Eronwu/roc_robot/application/roc_car/docs/env_part.md

# 软件环境搭建篇

这部分直接参考官方给的环境搭建，非常完整，不在重复编写
STM32 运行：https://github.com/RT-Thread/rt-thread/tree/master/bsp/stm32
ENV工具：ENV工具可以通过以下链接获取：https://pan.baidu.com/s/1cg28rk#list/path=%2F
