Eronwu/roc_robot/application/roc_car/docs/mobile_wifi_code_part.md

# 手机wifi控制篇

### 简介

- 协议部分同文档[小车应用篇](app_code_part.md#协议部分) - 【协议部分】说明
- 使用标准tcp协议进行连接通信
- 通过不同按键响应拼凑不同字节流进行tcp socket 数据发送

### 开发环境

Android studio

需要的可以通过这里下载[android app](https://github.com/emakefun/hummer-bot/blob/Hummer-bot4.0/APP/Emakefun_Robot.apk)

PC端软件 还有点小bug 用QT开发
