Eronwu/roc_robot/(list of files, cad)

Other CAD files:
application/roc_car/docs/roc_robot_structure.SLDDRW
