Eronwu/roc_robot/application/roc_car/applications/wifi_connect.c

/*
 * Copyright (c) 2006-2018, RT-Thread Development Team
 *
 * SPDX-License-Identifier: Apache-2.0
 *
 * Change Logs:
 * Date           Author       Notes
 * 2018-09-01     ZeroFree     first implementation
 */

#include <rtthread.h>
#include <rtdevice.h>
#include <board.h>
#include <msh.h>

#include <board.h>
#include <rtdevice.h>

#include "drv_wlan.h"
#include "wifi_config.h"

#include <stdio.h>
#include <stdlib.h>
#include <string.h>

#define DBG_SECTION_NAME "main"
#define DBG_LEVEL DBG_LOG
#include <rtdbg.h>

#define WLAN_SSID "emakefun"
#define WLAN_PASSWORD "emakefun501"
#define NET_READY_TIME_OUT (rt_tick_from_millisecond(15 * 1000))

#define WIFI_CONNECT_LED_PIN    PIN_LED_G

static void print_scan_result(struct rt_wlan_scan_result *scan_result);
static void print_wlan_information(struct rt_wlan_info *info);

static struct rt_semaphore net_ready;

void wlan_ready_handler(int event, struct rt_wlan_buff *buff, void *parameter)
{
    rt_sem_release(&net_ready);
}

/* 断开连接回调函数 */
void wlan_station_disconnect_handler(int event, struct rt_wlan_buff *buff, void *parameter)
{
    LOG_I("disconnect from the network!");
}

int wifi_auto_connect(void)
{
    int result = RT_EOK;
    struct rt_wlan_info info;
    struct rt_wlan_scan_result *scan_result;


   // rt_pin_write(WIFI_CONNECT_LED_PIN, PIN_LOW);
    /* 等待 500 ms 以便 wifi 完成初始化 */
    rt_hw_wlan_wait_init_done(500);

    /* 扫描热点 */
    LOG_D("start to scan ap ...");
    /* 执行同步扫描 */
    scan_result = rt_wlan_scan_sync();
    if (scan_result)
    {
        LOG_D("the scan is complete, results is as follows: ");
        /* 打印扫描结果 */
        print_scan_result(scan_result);
        /* 清除扫描结果 */
        rt_wlan_scan_result_clean();
    } else {
        LOG_E("not found ap information ");
        return -1;
    }

    /* 热点连接 */
    LOG_D("start to connect ap ...");
    rt_sem_init(&net_ready, "net_ready", 0, RT_IPC_FLAG_FIFO);

    /* 注册 wlan ready 回调函数 */
    rt_wlan_register_event_handler(RT_WLAN_EVT_READY, wlan_ready_handler, RT_NULL);
    /* 注册 wlan 断开回调函数 */
    rt_wlan_register_event_handler(RT_WLAN_EVT_STA_DISCONNECTED, wlan_station_disconnect_handler, RT_NULL);
    result = rt_wlan_connect(WLAN_SSID, WLAN_PASSWORD);
    if (result == RT_EOK) {
        rt_memset(&info, 0, sizeof(struct rt_wlan_info));
        /* 获取当前连接热点信息 */
        rt_wlan_get_info(&info);
        LOG_D("station information:");
        print_wlan_information(&info);
        /* 等待成功获取 IP */
        result = rt_sem_take(&net_ready, NET_READY_TIME_OUT);
        if (result == RT_EOK)
        {
            LOG_D("networking ready!");
            rt_pin_mode(WIFI_CONNECT_LED_PIN, PIN_MODE_OUTPUT);
            rt_pin_write(WIFI_CONNECT_LED_PIN, PIN_HIGH);
            msh_exec("ifconfig", rt_strlen("ifconfig"));
        } else {
            LOG_D("wait ip got timeout!");
        }
        /* 回收资源 */
        rt_wlan_unregister_event_handler(RT_WLAN_EVT_READY);
        rt_sem_detach(&net_ready);
    } else {
        LOG_E("The AP(%s) is connect failed!", WLAN_SSID);
    }

    rt_thread_mdelay(3000);
	// LOG_D("ready to disconect from ap ...");
	// rt_wlan_disconnect();

	/* 自动连接 */
	//  LOG_D("start to autoconnect ...");
	/* 初始化自动连接配置 */
	// wlan_autoconnect_init();
	/* 使能 wlan 自动连接 */
	//  rt_wlan_config_autoreconnect(RT_TRUE);

	//	rt_thread_mdelay(5000);
	//	rt_tc_test_init();
    return 0;
}

static void print_scan_result(struct rt_wlan_scan_result *scan_result)
{
    char *security;
    int index, num;

    num = scan_result->num;
    /* 有规则的排列扫描到的热点 */
    rt_kprintf("             SSID                      MAC            security    rssi chn Mbps\n");
    rt_kprintf("------------------------------- -----------------  -------------- ---- --- ----\n");
    for (index = 0; index < num; index++)
    {
        rt_kprintf("%-32.32s", &scan_result->info[index].ssid.val[0]);
        rt_kprintf("%02x:%02x:%02x:%02x:%02x:%02x  ",
                   scan_result->info[index].bssid[0],
                   scan_result->info[index].bssid[1],
                   scan_result->info[index].bssid[2],
                   scan_result->info[index].bssid[3],
                   scan_result->info[index].bssid[4],
                   scan_result->info[index].bssid[5]);
        switch (scan_result->info[index].security)
        {
        case SECURITY_OPEN:
            security = "OPEN";
            break;
        case SECURITY_WEP_PSK:
            security = "WEP_PSK";
            break;
        case SECURITY_WEP_SHARED:
            security = "WEP_SHARED";
            break;
        case SECURITY_WPA_TKIP_PSK:
            security = "WPA_TKIP_PSK";
            break;
        case SECURITY_WPA_AES_PSK:
            security = "WPA_AES_PSK";
            break;
        case SECURITY_WPA2_AES_PSK:
            security = "WPA2_AES_PSK";
            break;
        case SECURITY_WPA2_TKIP_PSK:
            security = "WPA2_TKIP_PSK";
            break;
        case SECURITY_WPA2_MIXED_PSK:
            security = "WPA2_MIXED_PSK";
            break;
        case SECURITY_WPS_OPEN:
            security = "WPS_OPEN";
            break;
        case SECURITY_WPS_SECURE:
            security = "WPS_SECURE";
            break;
        default:
            security = "UNKNOWN";
            break;
        }
        rt_kprintf("%-14.14s ", security);
        rt_kprintf("%-4d ", scan_result->info[index].rssi);
        rt_kprintf("%3d ", scan_result->info[index].channel);
        rt_kprintf("%4d\n", scan_result->info[index].datarate / 1000000);
    }
    rt_kprintf("\n");
}

static void print_wlan_information(struct rt_wlan_info *info)
{
    LOG_D("SSID : %-.32s", &info->ssid.val[0]);
    LOG_D("MAC Addr: %02x:%02x:%02x:%02x:%02x:%02x", info->bssid[0],
          info->bssid[1],
          info->bssid[2],
          info->bssid[3],
          info->bssid[4],
          info->bssid[5]);
    LOG_D("Channel: %d", info->channel);
    LOG_D("DataRate: %dMbps", info->datarate / 1000000);
    LOG_D("RSSI: %d", info->rssi);
}
