Eronwu/roc_robot/(commit log)

2019-07-26 init roc_robot project
    [kconfig-language.txt, kconfig.txt]
2019-08-14 Revert "init roc_robot project"
    This reverts commit 289536edc87f20ccbe91658a2a080c6becae6ca9.
    [kconfig-language.txt, kconfig.txt]
2019-08-14 Rebuild new roc robot project
    1. Build in board wifi module AP6181
    2. Use the new version rt-robot
    3. Porting 4 line pwm
    [kconfig-language.txt, kconfig.txt]
2019-08-18 Dual pwm control to single pwm control
    Dual pwm control to single pwm control
2019-08-24 重构目录，增加doc 部分文档
2019-08-25 添加器件选型说明
    [roc_robot_structure.SLDDRW]
2019-09-04 添加安装和接线说明
2019-09-05 完善遥控功能
2019-09-05 完善制作文档
2019-09-05 添加制作过程说明
